TeamPracticalProjects/Bare_Bones_Programming_Shield/Software/Bare_Bones_Blink/Bare_Bones_Blink.ino

/*
  Bare Bones Blink

  Based upon the example Blink sketch that comes with the Arduino IDE>
    This is the generic Blink sketch, modified to replace LED)BUILTIN with Arduino digital pin 4
    For use in testing the Bare Bones programmer; see:  
    https://github.com/TeamPracticalProjects/Bare_Bones_Programming_Shield

  Turns an LED on for one second, then off for one second, repeatedly.

  Most Arduinos have an on-board LED you can control. On the UNO, MEGA and ZERO
  it is attached to digital pin 13, on MKR1000 on pin 6. LED_BUILTIN is set to
  the correct LED pin independent of which board is used.
  If you want to know what pin the on-board LED is connected to on your Arduino
  model, check the Technical Specs of your board at:
  https://docs.arduino.cc/hardware/

  modified 8 May 2014
  by Scott Fitzgerald
  modified 2 Sep 2016
  by Arturo Guadalupi
  modified 8 Sep 2016
  by Colby Newman

  modified 16 March 2026
  by Bob Glicksman

  This example code is in the public domain.

  https://docs.arduino.cc/built-in-examples/basics/Blink/
*/

// the setup function runs once when you press reset or power the board
void setup() {
  // initialize digital pin LED_BUILTIN as an output.
  pinMode(4, OUTPUT);
}

// the loop function runs over and over again forever
void loop() {
  digitalWrite(4, HIGH);  // change state of the LED by setting the pin to the HIGH voltage level
  delay(1000);                      // wait for a second
  digitalWrite(4, LOW);   // change state of the LED by setting the pin to the LOW voltage level
  delay(1000);                      // wait for a second
}
